zbauman3/digi-roll/README.md

# DigiRoll

A digital dice roller for D&D. Check out the docs site at https://zbauman3.github.io/digi-roll/

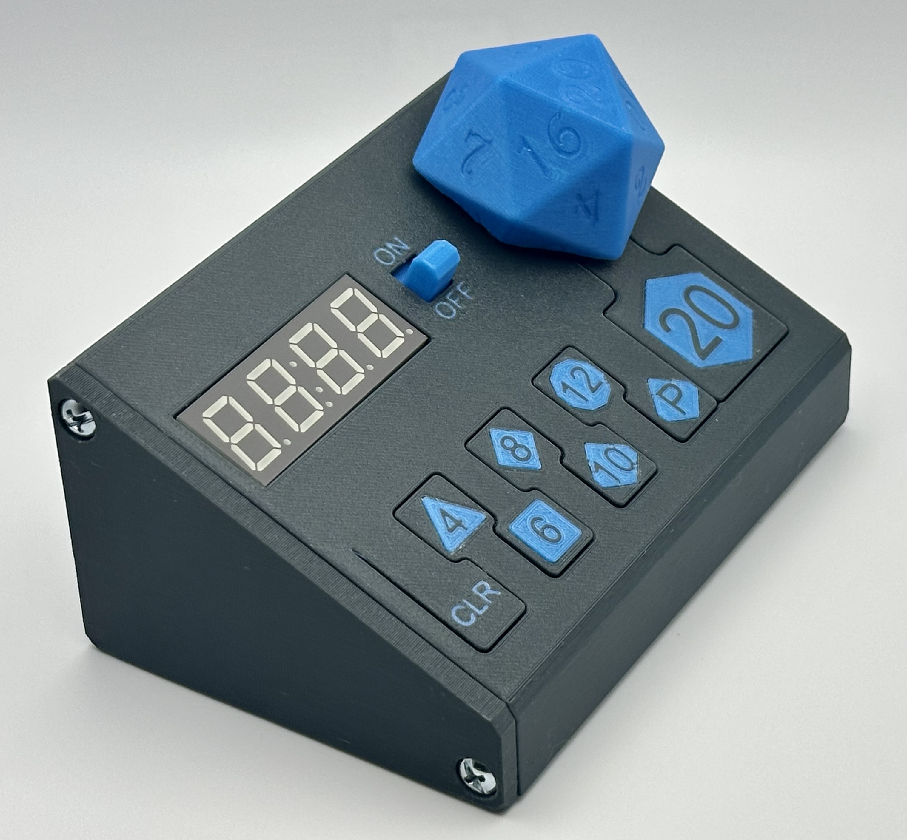
[picture p1: docs/assets/media/assembled/front-side.jpeg]
