zbauman3/digi-roll/docs/media.md

---
layout: default
title: Media
---

- [Assembled](#assembled)
- [PCB](#pcb)
- [Prototype](#prototype)
- [Schemas](#schemas)

## Assembled

<video controls="controls" class="img-full">
  <source src="./assets/media/assembled/usage-demo-1.MOV">
</video>

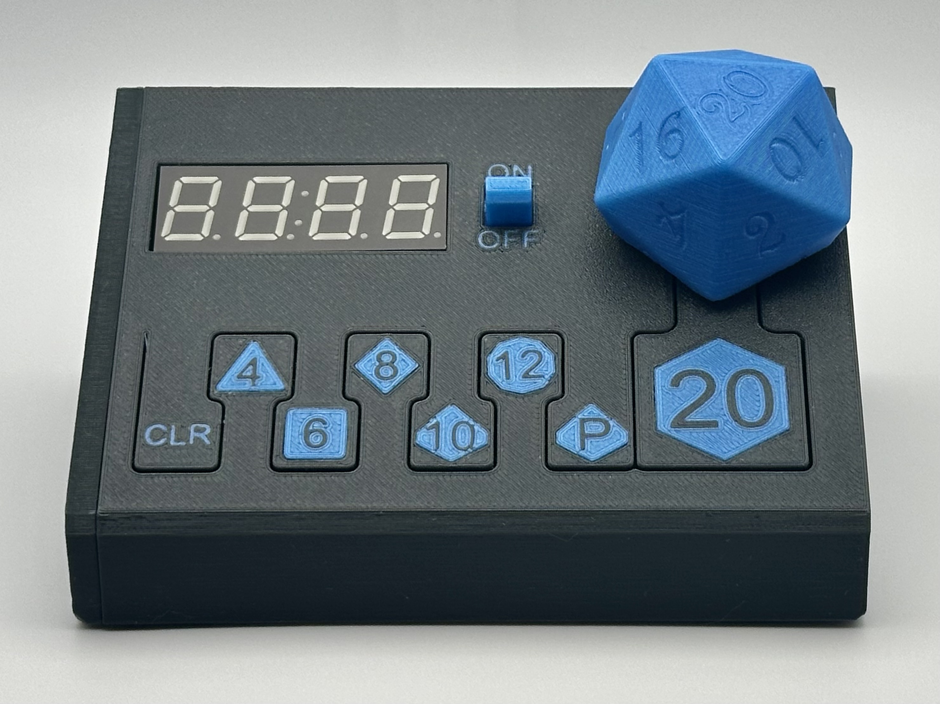
[picture p4: docs/assets/media/assembled/front.jpeg]




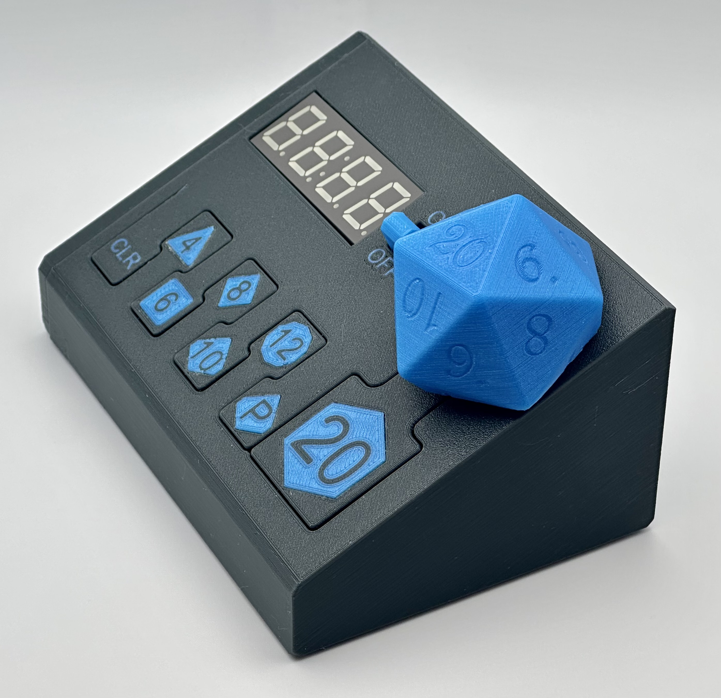
[picture p5: docs/assets/media/assembled/front-side-2.jpeg]


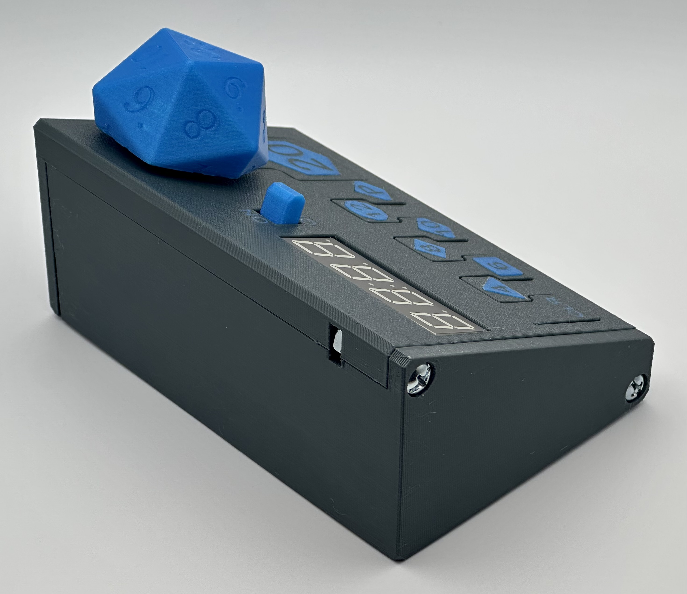
[picture p6: docs/assets/media/assembled/back-side.jpeg]


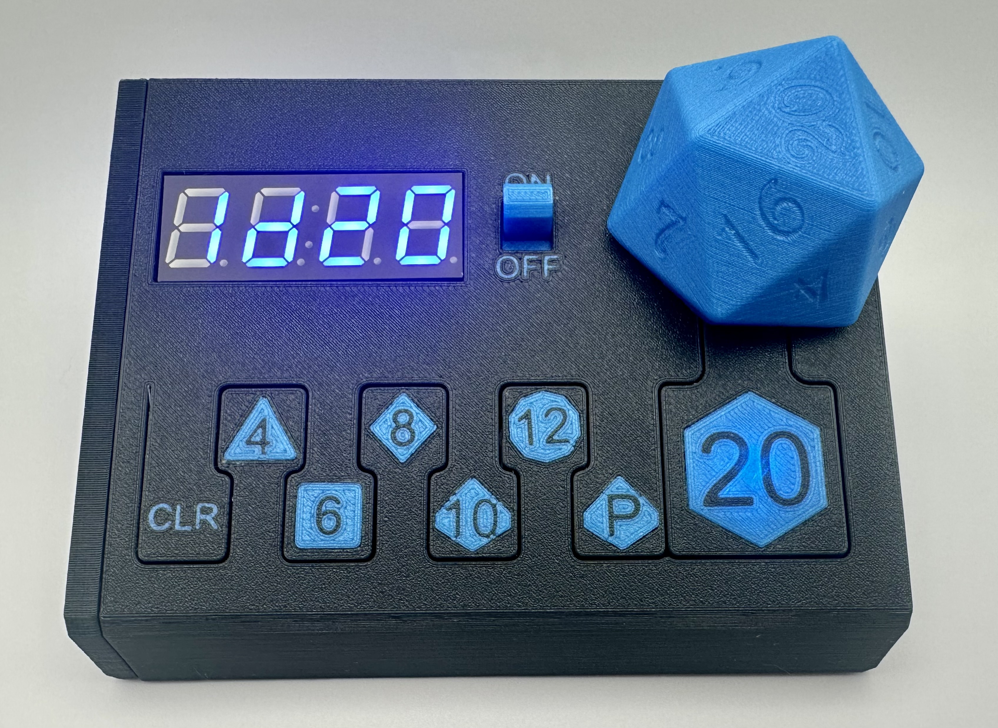
[picture p7: docs/assets/media/assembled/front-on.jpeg]


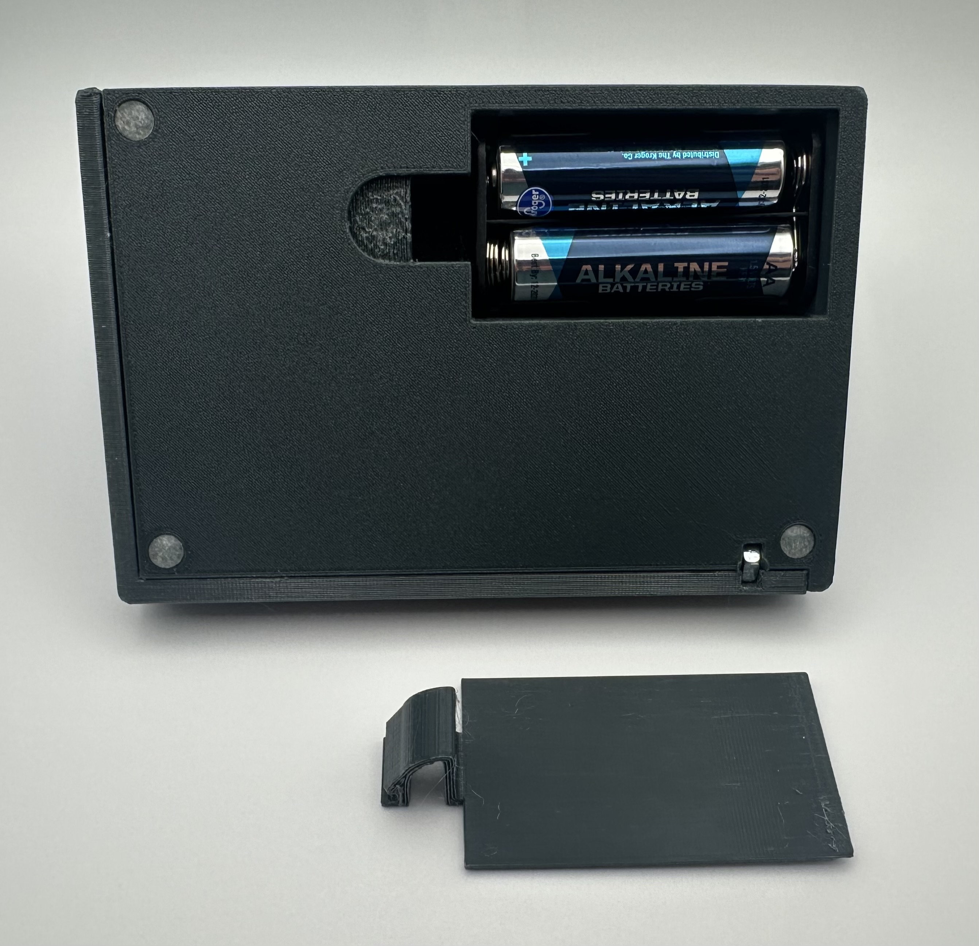
[picture p8: docs/assets/media/assembled/back.jpeg]


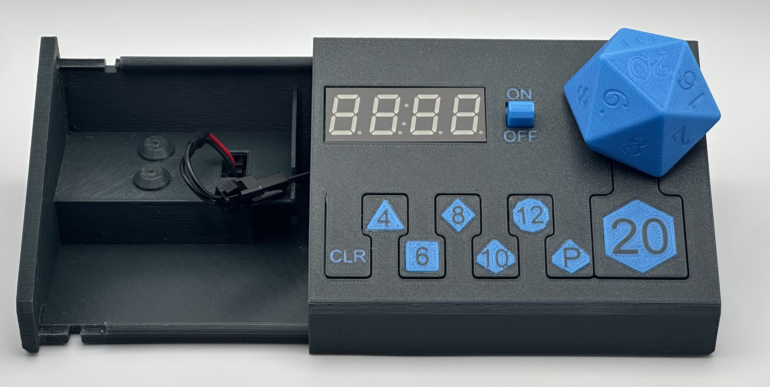
[picture p9: docs/assets/media/assembled/front-open.jpeg]


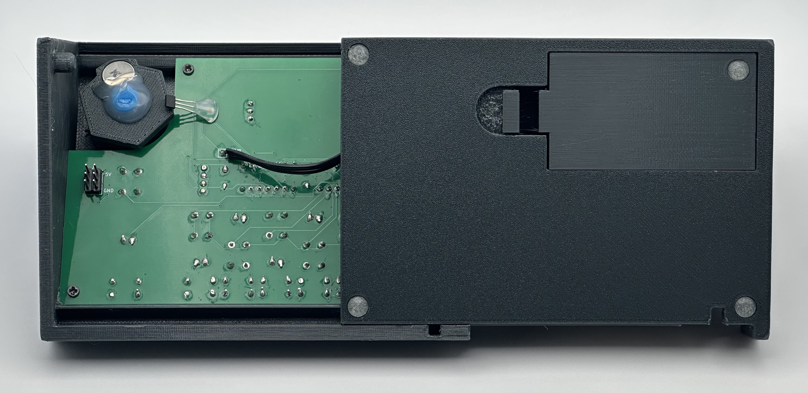
[picture p10: docs/assets/media/assembled/back-open.jpeg]


## PCB

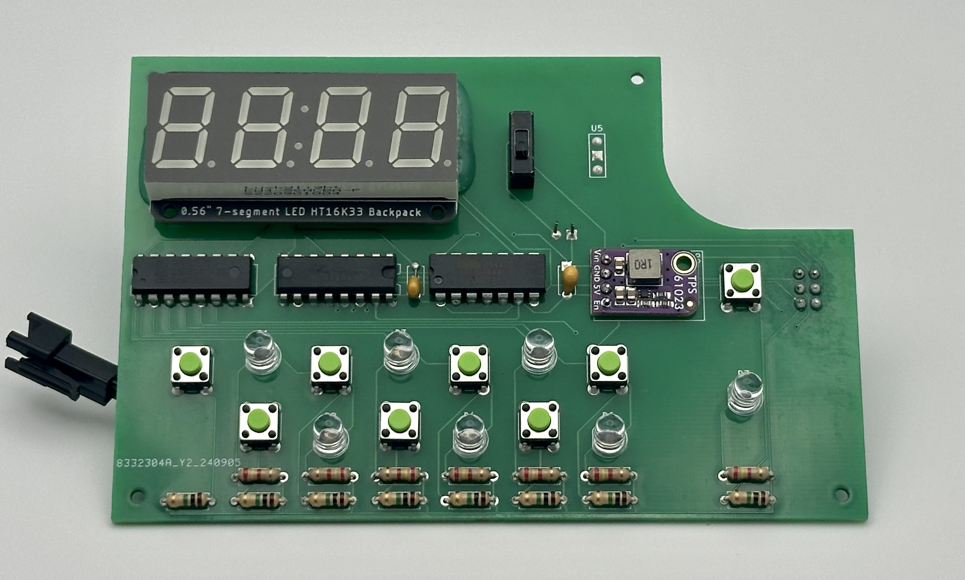
[picture p11: docs/assets/media/wip/assembled-pcb-front.jpeg]


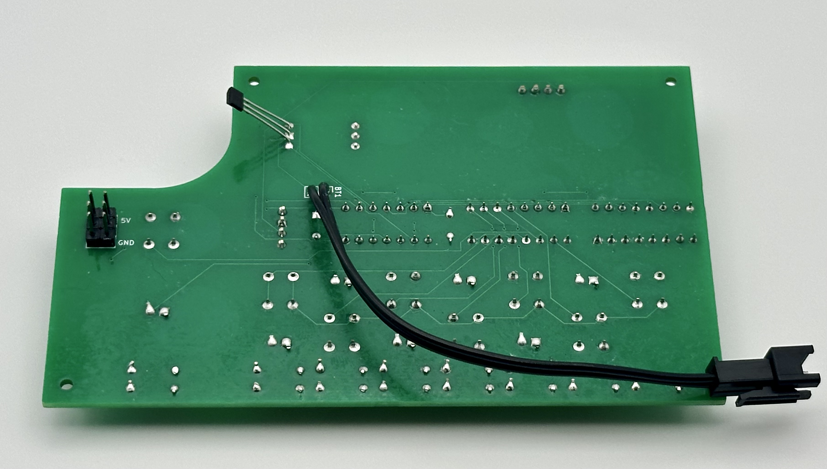
[picture p12: docs/assets/media/wip/assembled-pcb-back.jpeg]


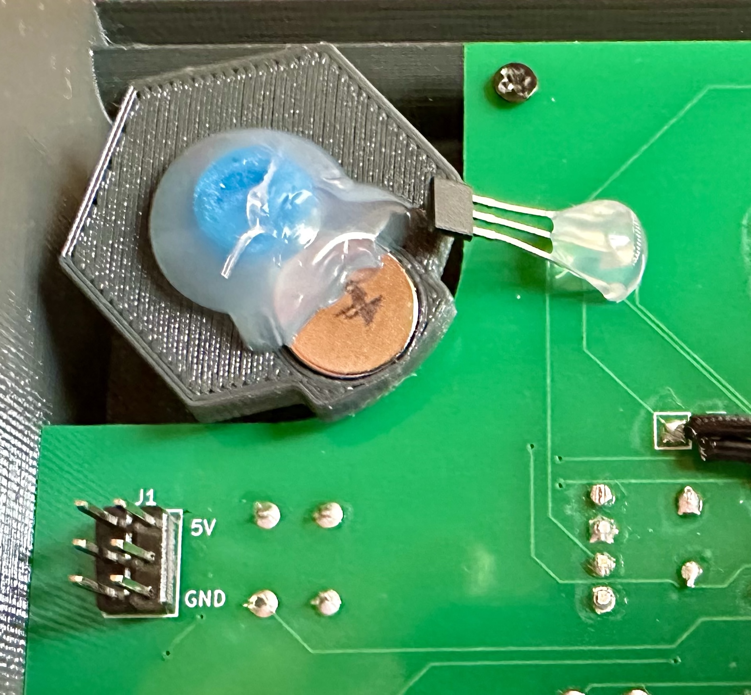
[picture p13: docs/assets/media/assembled/spinner.jpeg]


## Prototype

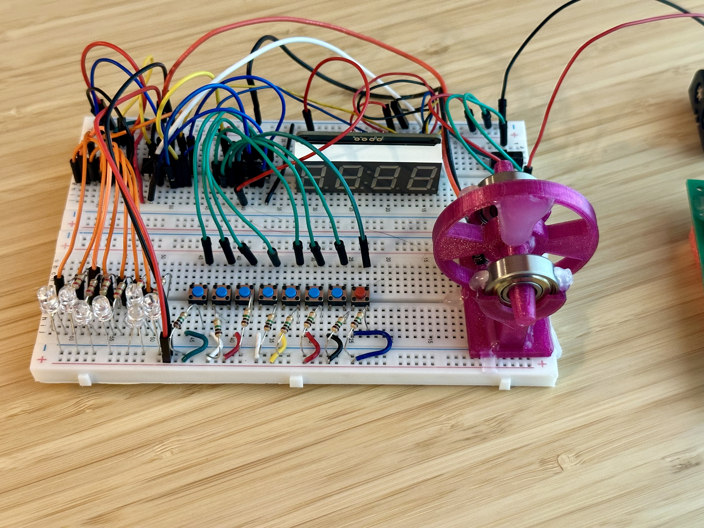
[picture p14: docs/assets/media/wip/prototype.jpeg]


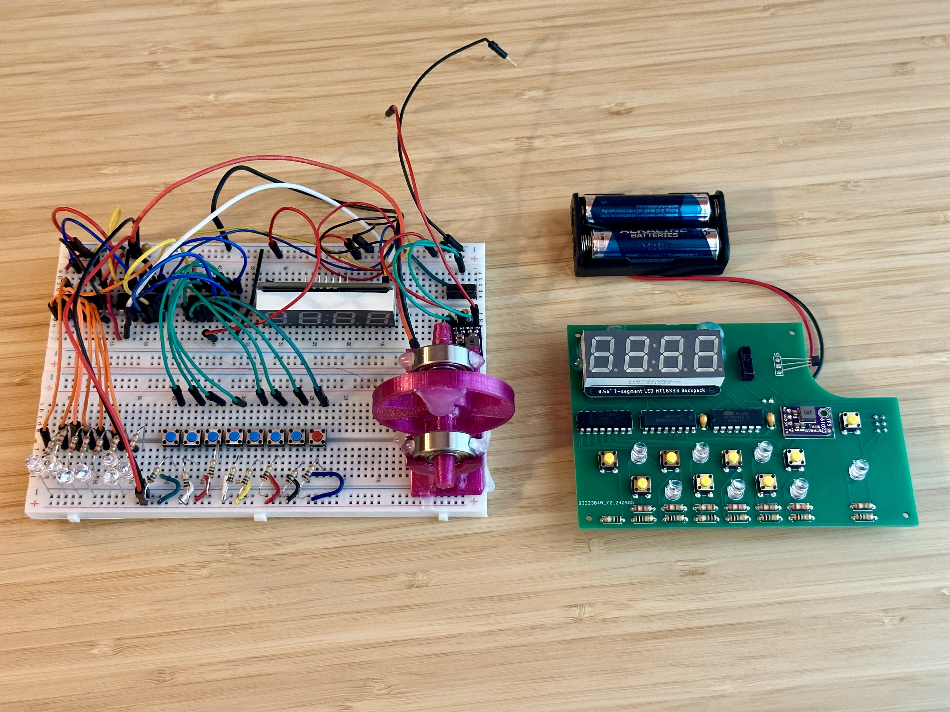
[picture p15: docs/assets/media/wip/prototype-pcb.jpeg]


## Schemas

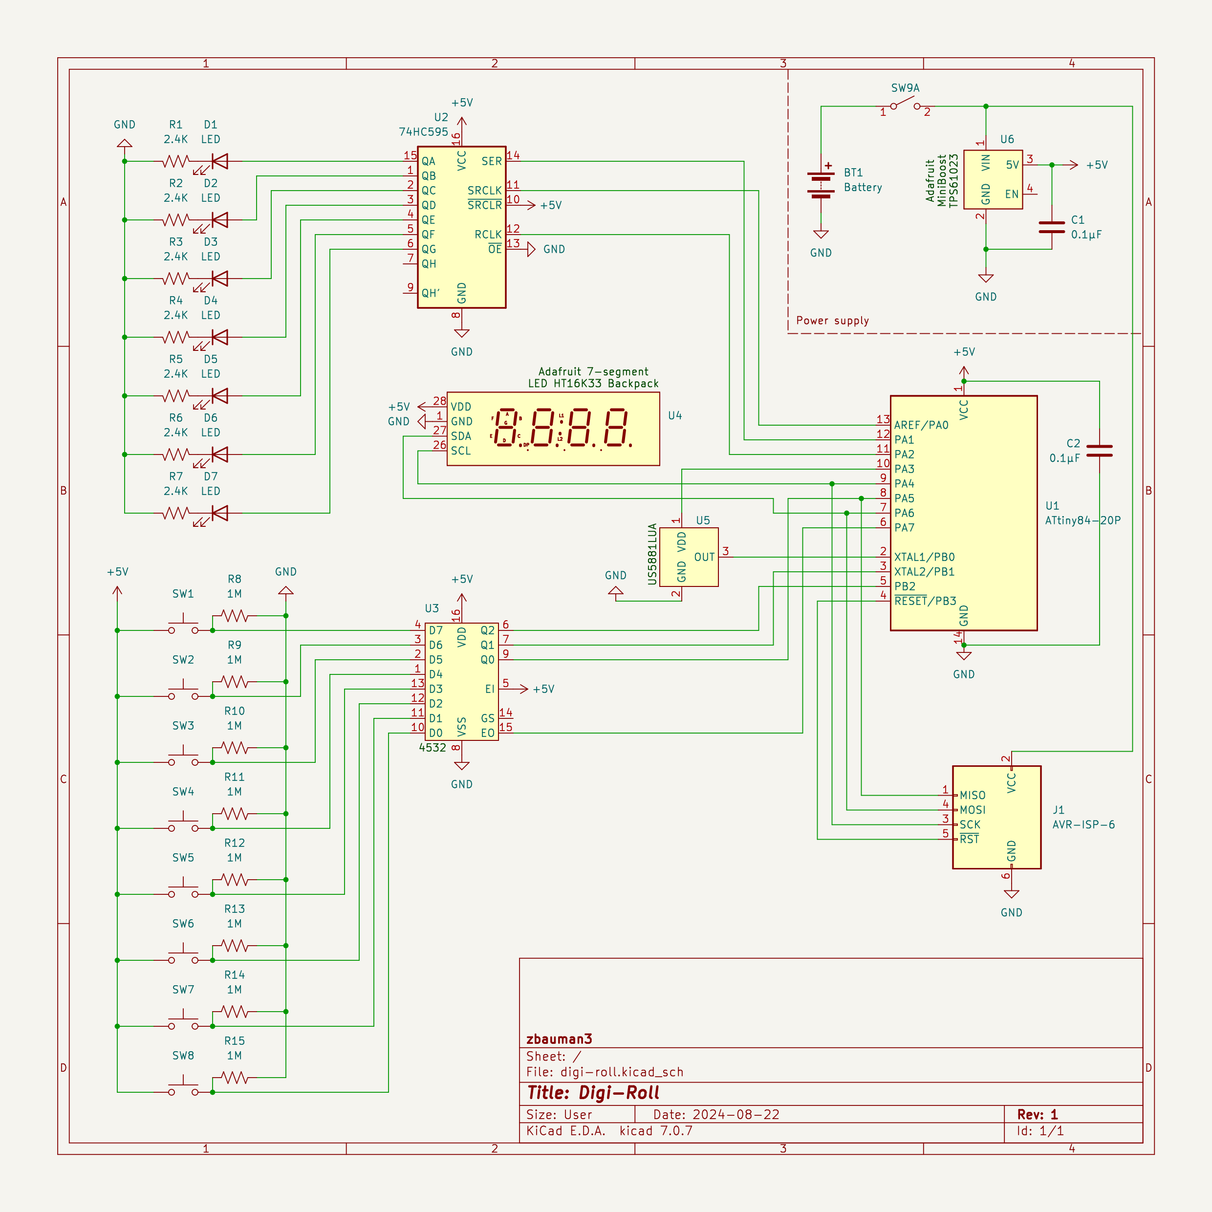
[picture p16: docs/assets/KiCad/schema.png]


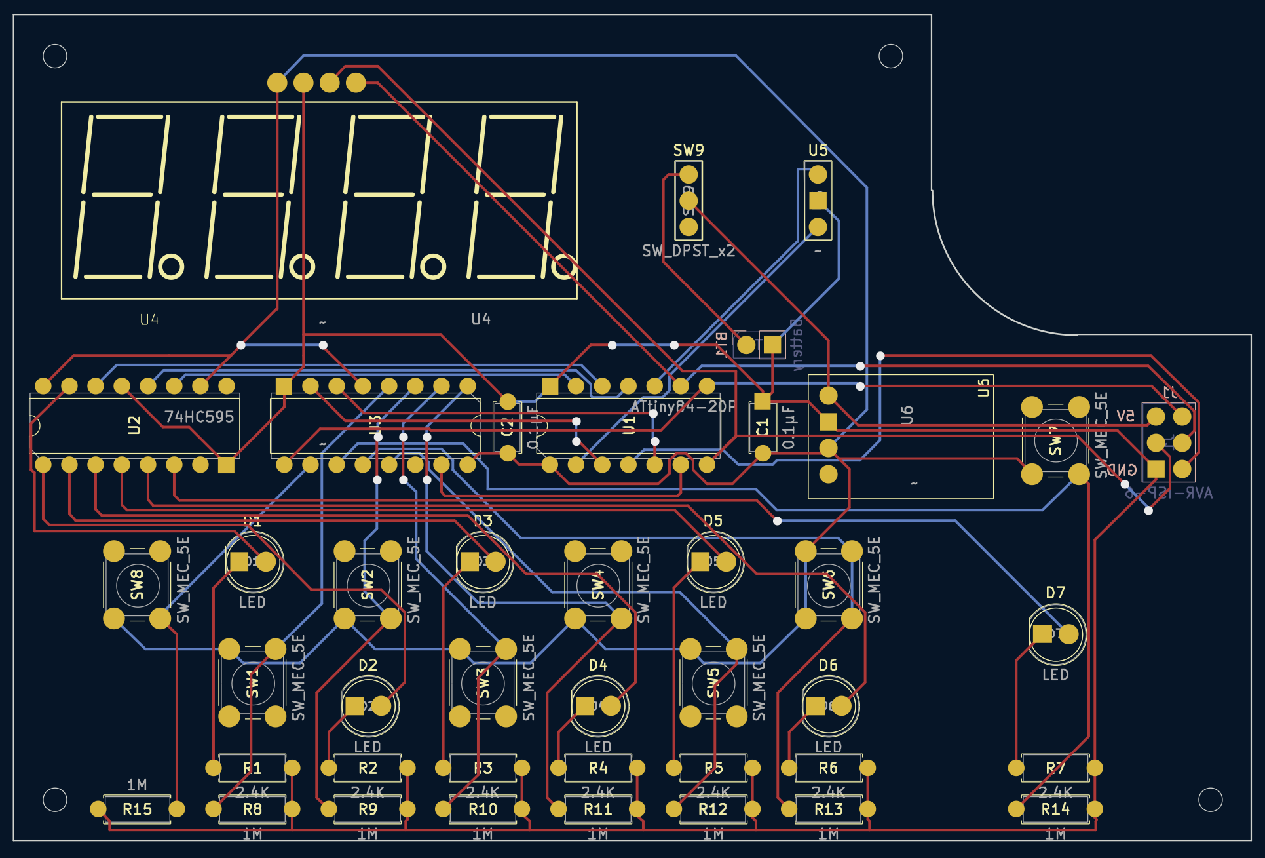
[picture p17: docs/assets/KiCad/pcb.png]
