zbauman3/digi-roll/docs/assets/media/power/active-peaks.png

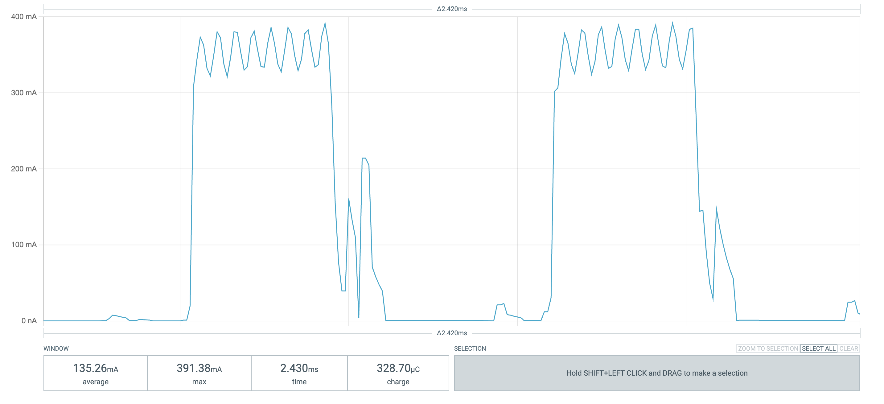
docs/assets/media/power/active-peaks.png
