zbauman3/digi-roll/docs/assets/media/power/pre-sleep-large.png

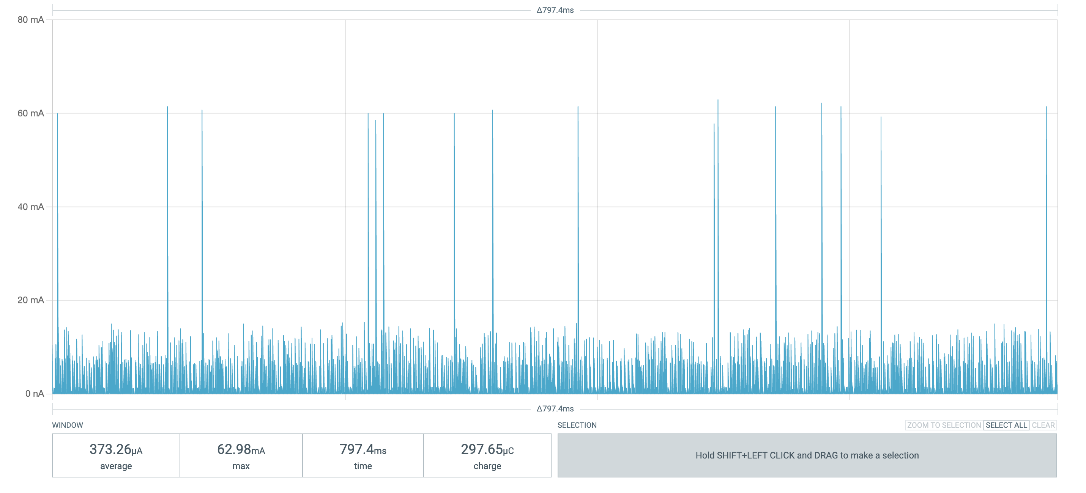
docs/assets/media/power/pre-sleep-large.png
