zbauman3/digi-roll/docs/assets/media/power/pre-sleep-peaks.png

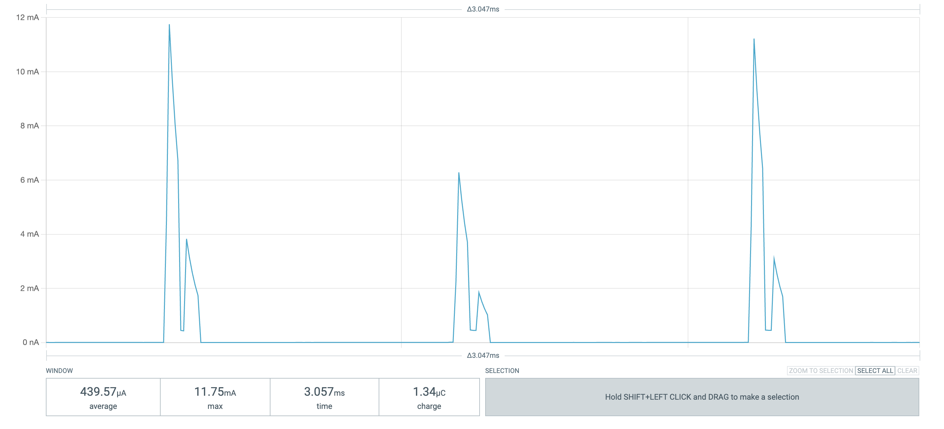
docs/assets/media/power/pre-sleep-peaks.png
