zbauman3/digi-roll/docs/assets/media/power/sleep-lows.png

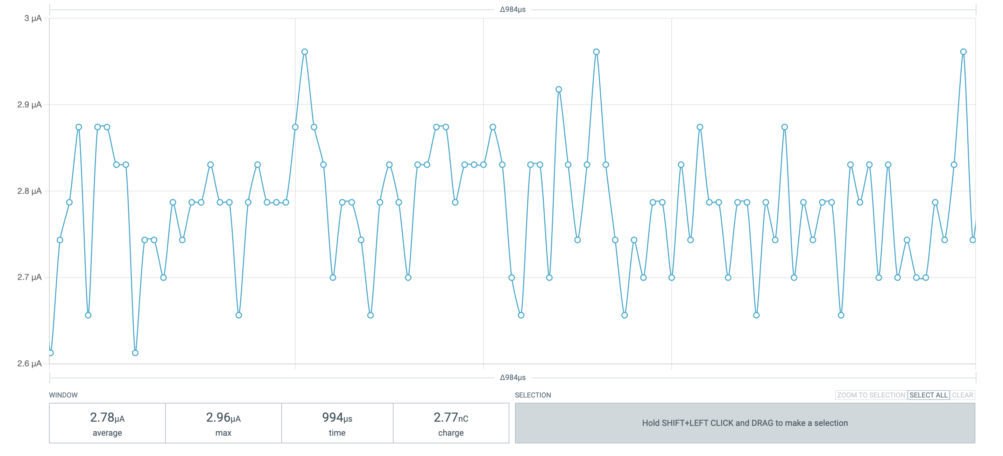
docs/assets/media/power/sleep-lows.png
