zbauman3/digi-roll/docs/assets/media/power/sleep-peaks.png

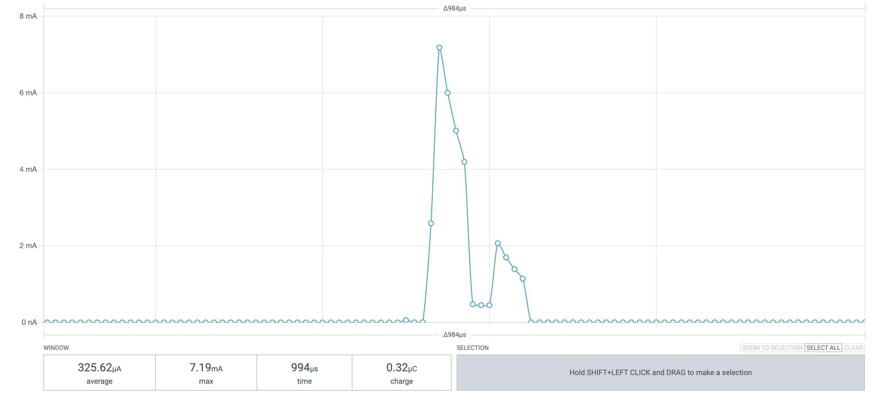
docs/assets/media/power/sleep-peaks.png
