zbauman3/digi-roll/docs/parts.md

---
layout: default
title: Parts
---

- [3D Printed Case](#3d-printed-case)
- [Electronics](#electronics)
- [Misc](#misc)

## 3D Printed Case

| Filament | Parts | Link |
| --- | --- | --- |
| Prusament PETG Anthracite Grey | External case | [Prusa](https://www.prusa3d.com/product/prusament-petg-anthracite-grey-1kg/) |
| Prusament PLA Azure Blue | Buttons, power switch, and dice spinner | [Prusa](https://www.prusa3d.com/product/prusament-pla-azure-blue-1kg/) |

## Electronics

| Part | Description | Count | Link |
| --- | --- | ----- | --- |
| ATTINY84A | Main MCU | 1 | [Mouser](https://www.mouser.com/ProductDetail/556-ATTINY84A-PU) |
| CD4532BE | 8-bit priority encoder (Buttons) | 1 | [Mouser](https://www.mouser.com/ProductDetail/595-CD4532BE) |
| SN74HC595N | Shift register (LEDs) | 1 | [Mouser](https://www.mouser.com/ProductDetail/595-SN74HC595N) |
| 7-Segment Display Breakout | I2C, 4 digit display | 1 | [Adafruit](https://www.adafruit.com/product/881) |
| TPS61023 Breakout | Boost converter | 1 | [Adafruit](https://www.adafruit.com/product/4654) |
| WP7113LVBC/D (LED) | Low current LEDs | 7 | [Mouser](https://www.mouser.com/ProductDetail/604-WP7113LVBCD) |
| 2.4K Ohm Resistors | LED resistors | 7 | [Mouser](https://www.mouser.com/ProductDetail/603-CFR-25JR-52-2K4) |
| Tactile Switches | 6 x 6 x 5mm buttons | 8 | [Adafruit](https://www.adafruit.com/product/4184) |
| 1M Ohm Resistors | Button resistors | 8 | [Mouser](https://www.mouser.com/ProductDetail/603-CFR-25JR-521M) |
| 0.1uF 50V Capacitors | Power stabilization | 2 | [Mouser](https://www.mouser.com/ProductDetail/594-K104K15X7RF5TL2) |
| SPDT Slide Switch | Power switch | 1 | [Adafruit](https://www.adafruit.com/product/805) |
| US5881UA | Hall effect sensor | 1 | [Mouser](https://www.mouser.com/ProductDetail/482-5881LUAAAA000BU) |
| Battery Holder | 2 x 1.5V AA | 1 | [Amazon](https://www.amazon.com/dp/B013GNC08C) |

## Misc

| Part | Description | Count | Link |
| --- | --- | ----- | --- |
| Rubber Feet | For the bottom of the case | 4 | [Amazon](https://www.amazon.com/dp/B07R17T68B) |
| Bearings | For the dice spinner | 2 | [Amazon](https://www.amazon.com/dp/B000OYU0TS) |
| Magnets | For the dice spinner | 1 | [Amazon](https://www.amazon.com/gp/product/B09WZTSQ9Y) |
| Battery Connectors | Allows disconnecting the battery from the board for easy installation | 1 | [Adafruit](https://www.adafruit.com/product/2880) |
| PCB Screws | M2 x 8mm | 4 | N/A |
| Hot glue | Securing the display and the magnet holer | - | N/A |
| Tacking screws | Attaching the battery holder to the case | 2 | N/A |
| Header pins | Attaching the breakout boards and a ISP connection for programming | 14 | N/A |
