zbauman3/digi-roll/docs/assets/KiCad/digi-roll.kicad_pcb

## KiCad design docs/assets/KiCad/digi-roll.kicad_pcb (2024-09-13)

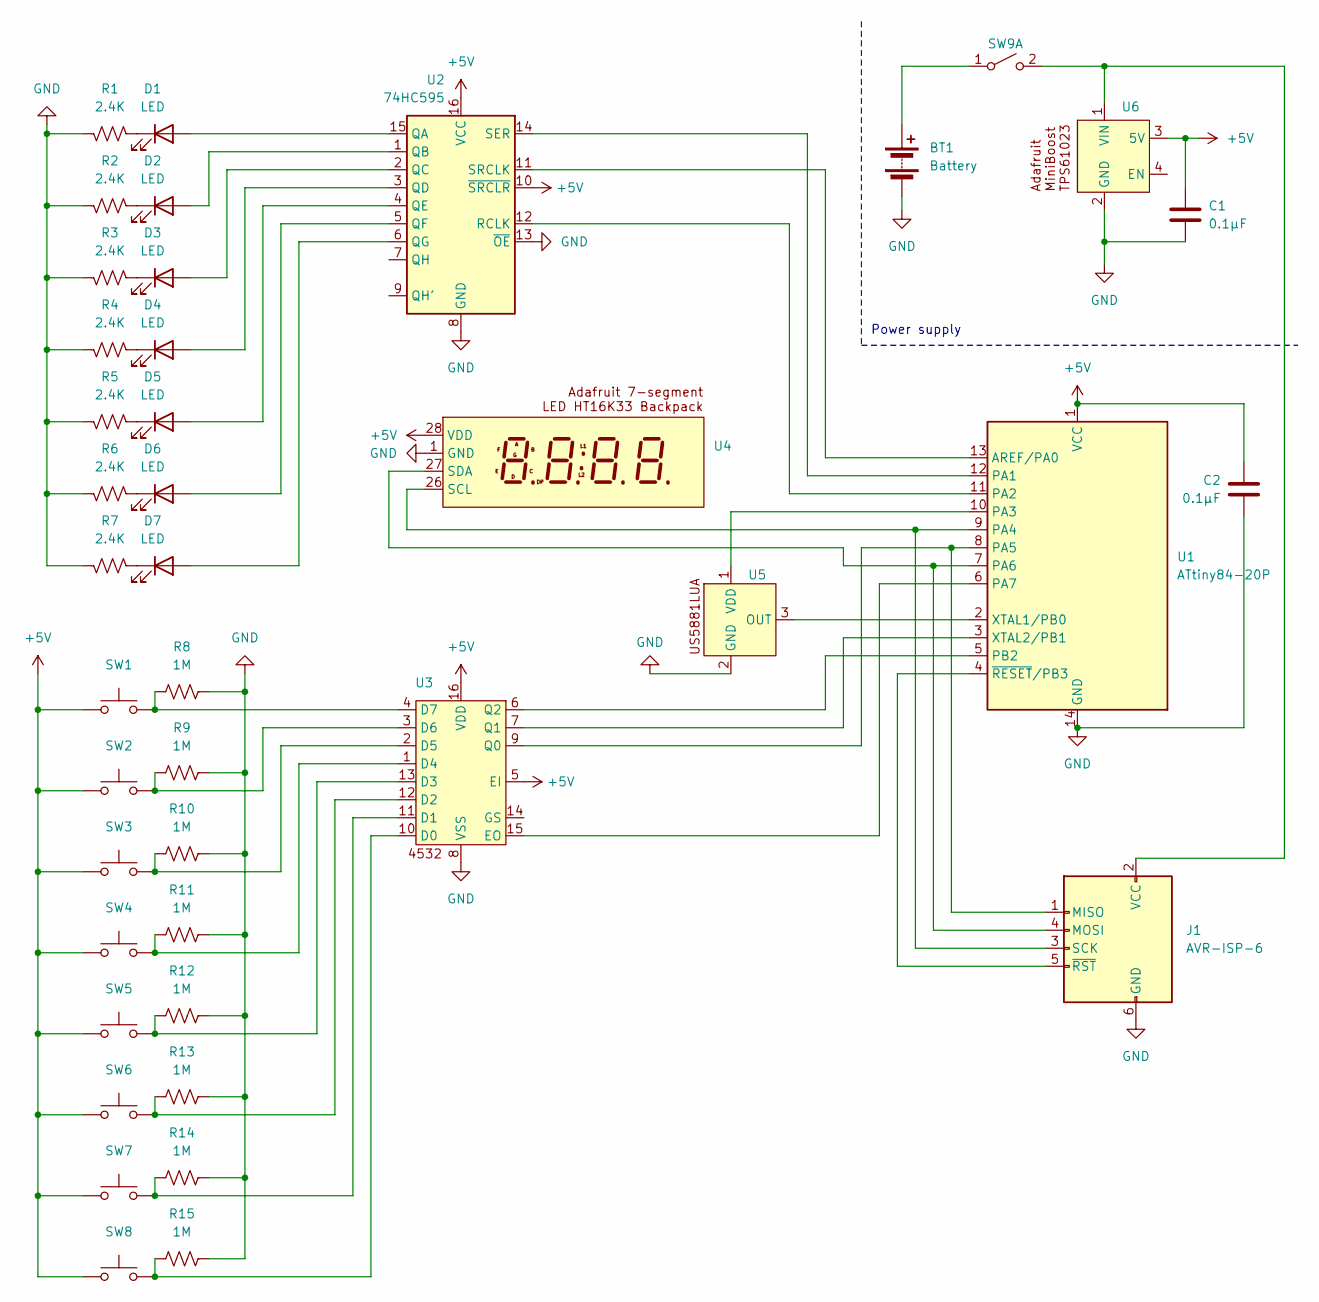
[picture p23: schematic digi-roll.kicad_sch]

Parts:
BT1: Battery; PinHeader_1x02_P2.54mm_Vertical
C1, C2: 0.1µF; C_Disc_D4.7mm_W2.5mm_P5.00mm
D1, D2, D3, D4, D5, D6, D7: LED; LED_D5.0mm
J1: AVR-ISP-6; PinHeader_2x03_P2.54mm_Vertical
R1, R2, R3, R4, R5, R6, R7: 2.4K; R_Axial_DIN0207_L6.3mm_D2.5mm_P7.62mm_Horizontal
R8, R9, R10, R11, R12, R13, R14, R15: 1M; R_Axial_DIN0207_L6.3mm_D2.5mm_P7.62mm_Horizontal
SW1, SW2, SW3, SW4, SW5, SW6, SW7, SW8: SW_MEC_5E; SW_PUSH_6mm_H5mm
SW9: SW_DPST_x2; PinHeader_1x02_P2.54mm_Vertical
U1: ATtiny84-20P; DIP-14_W7.62mm
U2: 74HC595; DIP-16_W7.62mm
U3: DIP-16_W7.62mm
U4: Adafruit_7_seg
U5: PinHeader_1x03_P2.54mm_Vertical
U6: Adafruit_Miniboost

Connections:
+5V: C1.1, C2.1, SW1.1, SW2.1, SW3.1, SW4.1, SW5.1, SW6.1, SW7.1, SW8.1, U1.1 (VCC), U2.10 (~SRCLR), U2.16 (VCC), U3.5 (EI), U3.16 (VDD), U4.28 (VDD), U6.3 (5V)
GND: BT1.2 (-), C1.2, C2.2, J1.6 (GND), R1.2, R2.2, R3.2, R4.2, R5.2, R6.2, R7.2, R8.2, R9.2, R10.2, R11.2, R12.2, R13.2, R14.2, R15.2, U1.14 (GND), U2.8 (GND), U2.13 (~OE), U3.8 (VSS), U4.1 (GND), U5.2 (GND), U6.2 (GND)
unnamed: BT1.1 (+), SW9.1 (A)
unnamed: D1.2 (A), U2.15 (QA)
unnamed: D1.1 (K), R1.1
unnamed: D2.2 (A), U2.1 (QB)
unnamed: D2.1 (K), R2.1
unnamed: D3.2 (A), U2.2 (QC)
unnamed: D3.1 (K), R3.1
unnamed: D4.2 (A), U2.3 (QD)
unnamed: D4.1 (K), R4.1
unnamed: D5.2 (A), U2.4 (QE)
unnamed: D5.1 (K), R5.1
unnamed: D6.2 (A), U2.5 (QF)
unnamed: D6.1 (K), R6.1
unnamed: D7.2 (A), U2.6 (QG)
unnamed: D7.1 (K), R7.1
unnamed: J1.1 (MISO), U1.8 (PA5), U3.9 (Q0)
unnamed: J1.4 (MOSI), U1.7 (PA6), U4.27 (SDA)
unnamed: J1.3 (SCK), U1.9 (PA4), U4.26 (SCL)
unnamed: J1.2 (VCC), SW9.2 (B), U6.1 (VIN)
unnamed: J1.5 (~RST), U1.4 (~RESET/PB3)
unnamed: U1.13 (AREF/PA0), U2.11 (SRCLK)
unnamed: U1.12 (PA1), U2.14 (SER)
unnamed: U1.11 (PA2), U2.12 (RCLK)
unnamed: U1.10 (PA3), U5.1 (VDD)
unnamed: U1.6 (PA7), U3.15 (EO)
unnamed: U1.5 (PB2), U3.6 (Q2)
unnamed: U1.2 (XTAL1/PB0), U5.3 (OUT)
unnamed: U1.3 (XTAL2/PB1), U3.7 (Q1)
unnamed: R15.1, SW8.2, U3.10 (D0)
unnamed: R14.1, SW7.2, U3.11 (D1)
unnamed: R13.1, SW6.2, U3.12 (D2)
unnamed: R12.1, SW5.2, U3.13 (D3)
unnamed: R11.1, SW4.2, U3.1 (D4)
unnamed: R10.1, SW3.2, U3.2 (D5)
unnamed: R9.1, SW2.2, U3.3 (D6)
unnamed: R8.1, SW1.2, U3.4 (D7)

Notes on the sheet:
Power supply

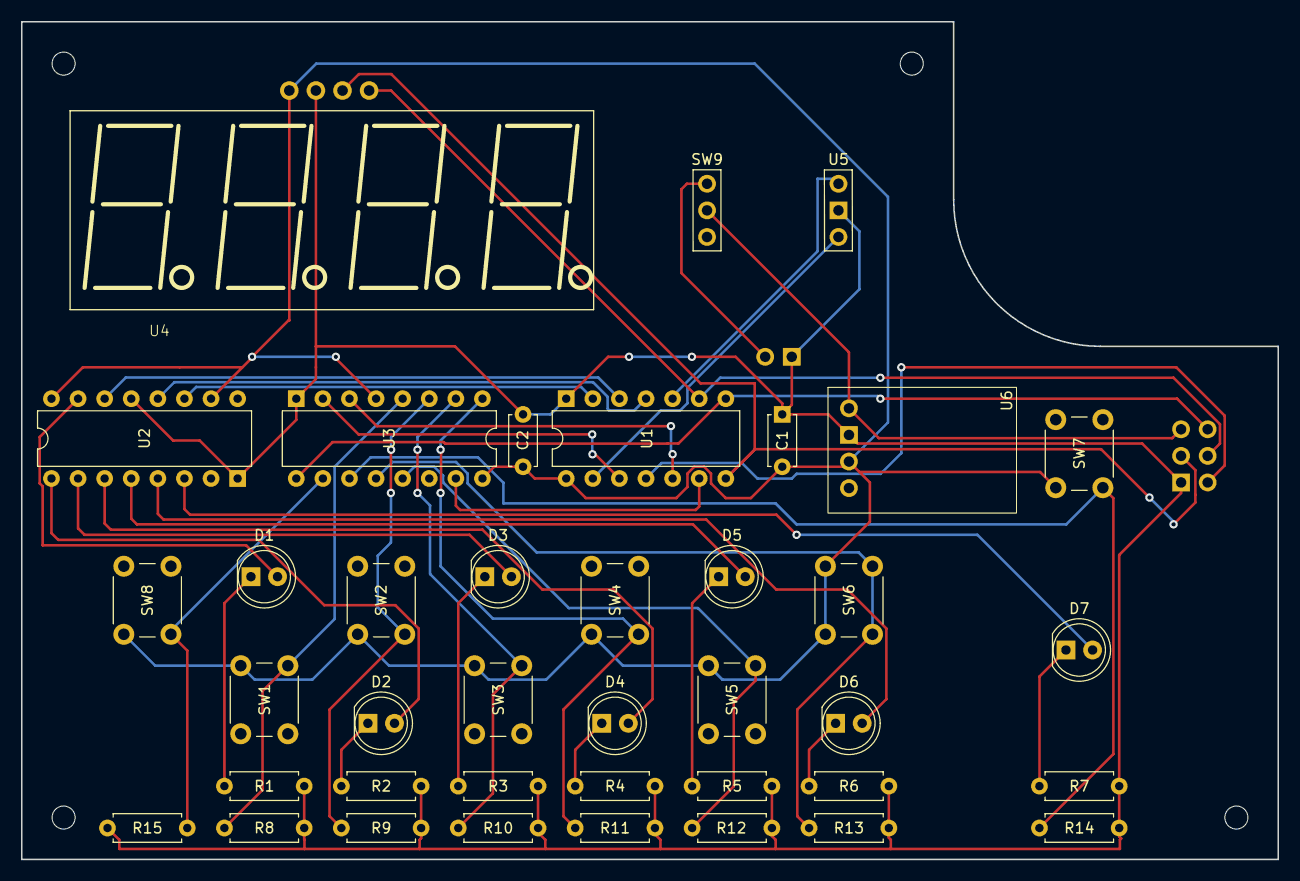
[picture p24: board digi-roll.kicad_pcb from above]

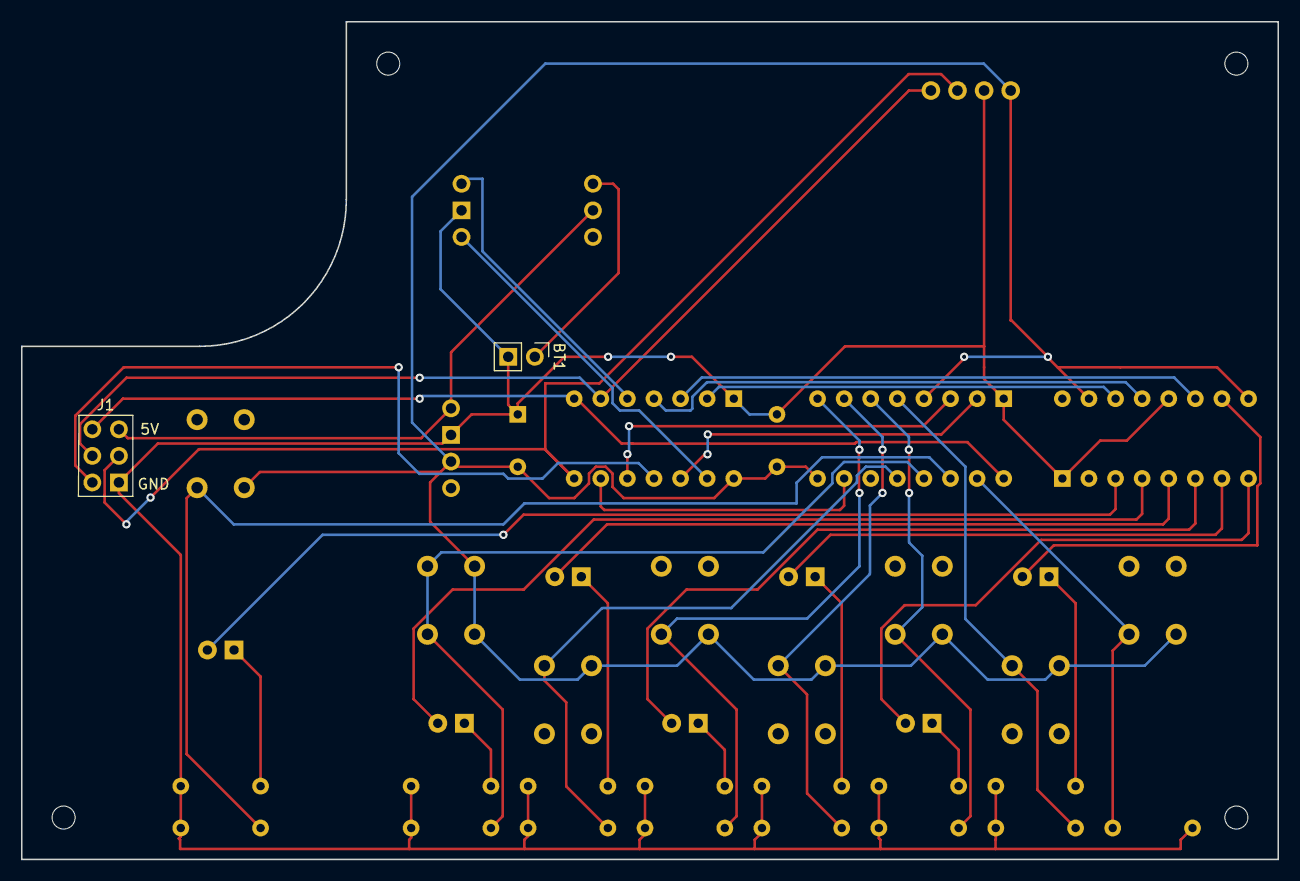
[picture p25: board digi-roll.kicad_pcb from below]

Board: 2 copper layers, 120.0 x 80.0 mm, 41 parts (2 on the bottom side), 38 nets.
