zbauman3/digi-roll/src/views/MatrixDisplay.cpp

#include "./MatrixDisplay.h"

// !! README !!
// Don't use the string functions from `Adafruit_7segment`.
// They take too much space.

MatrixDisplay::MatrixDisplay(State *_state) {
  this->state = _state;
  this->matrix = Adafruit_7segment();
};

void MatrixDisplay::begin() {
  this->matrix.begin(MATRIX_DISPLAY_ADDR);
  this->matrix.setBrightness(this->state->data.brightness);
  this->_lastBrightness = this->state->data.brightness;
}

void MatrixDisplay::loop() {
  if (this->state->isUpdateLoop) {
    // sleep/wake the HT16K33, otherwise is can use multiple mA.
    // `Adafruit_7segment` doesn't give access to its internal `Wire`, but it
    // defaults to the global one. So we can just use that too.
    // @see https://cdn-shop.adafruit.com/datasheets/ht16K33v110.pdf
    if (this->state->data.mode == STATE_MODE_SLEEP) {
      // clear anything
      this->matrix.clear();
      this->matrix.writeDisplay();
      // sleep the display
      uint8_t buffer[1] = {0x20};
      Wire.beginTransmission(MATRIX_DISPLAY_ADDR);
      while (Wire.write(buffer, 1) != 1) {
        delay(1);
      }
      Wire.endTransmission(true);

      // if sleeping, don't run the coroutine
      return;
    } else if (this->state->data.mode == STATE_MODE_WAKE) {
      // wake the display
      uint8_t buffer[1] = {0x21};
      Wire.beginTransmission(MATRIX_DISPLAY_ADDR);
      while (Wire.write(buffer, 1) != 1) {
        delay(1);
      }
      Wire.endTransmission(true);

      // if waking, reset
      this->reset();
    }
  }

  this->runCoroutine();
}

int MatrixDisplay::runCoroutine() {
  COROUTINE_LOOP() {
    if (this->state->isUpdateLoop) {
      if (this->_lastBrightness != this->state->data.brightness) {
        this->matrix.setBrightness(this->state->data.brightness);
        this->_lastBrightness = this->state->data.brightness;
        // yield after transmit to give others a turn to run
        COROUTINE_YIELD();
      }

      this->matrix.clear();

      if (this->state->data.mode == STATE_MODE_SELECT_DICE) {
        // show results in `2d20` format
        this->matrix.writeDigitNum(0, this->state->data.diceCount);
        this->matrix.writeDigitAscii(1, 'd');

        uint8_t diceCount = this->state->getDiceCount();
        switch (diceCount) {
        case 4:
        case 6:
        case 8:
          this->matrix.writeDigitNum(4, diceCount);
          break;
        case 10:
        case 12:
          this->matrix.writeDigitNum(3, 1);
          this->matrix.writeDigitNum(4, diceCount % 10);
          break;
        case 100:
          // It's a "percentile" roll, so we can show "P". "100" won't fit
          this->matrix.writeDigitAscii(4, 'P');
          break;
        case 20:
        default:
          this->matrix.writeDigitNum(3, 2);
          this->matrix.writeDigitNum(4, 0);
          break;
        }

        this->matrix.writeDisplay();
      } else if (this->state->data.mode == STATE_MODE_ROLLING) {
        // animate a circle around each segment in a row
        for (this->j = 0; this->j < 5; this->j++) {
          if (this->j == 2) {
            this->j++;
          }

          for (this->i = 0; this->i < 6; this->i++) {
            this->matrix.writeDigitRaw(this->j, (1 << this->i));
            this->matrix.writeDisplay();
            COROUTINE_DELAY(30);
          }

          this->matrix.writeDigitRaw(this->j, 1);
          this->matrix.writeDisplay();
          COROUTINE_DELAY(30);

          this->matrix.writeDigitRaw(this->j, 0);
          this->matrix.writeDisplay();
        }

        this->state->setModeResults();
      } else if (this->state->data.mode == STATE_MODE_RESULTS) {
        // show the results in `2. 20` format
        // only show the selected dice if more than one was rolled
        if (this->state->data.diceCount > 1) {
          // if resultIndex == diceCount, show the sum
          if (this->state->data.resultIndex == this->state->data.diceCount) {
            this->matrix.writeDigitAscii(0, '=');
          } else {
            this->matrix.writeDigitNum(0, this->state->data.resultIndex + 1,
                                       true);
          }
        }

        uint16_t dispResult = 0;

        // if resultIndex == diceCount, show the sum
        if (this->state->data.resultIndex == this->state->data.diceCount) {
          for (this->i = 0; this->i < this->state->data.diceCount; this->i++) {
            dispResult += this->state->data.results[this->i];
          }
        } else {
          dispResult = this->state->data.results[this->state->data.resultIndex];
        }

        if (dispResult < 10) {
          this->matrix.writeDigitNum(4, dispResult);
        } else if (dispResult < 100) {
          this->matrix.writeDigitNum(3, (uint8_t)ceil(dispResult / 10));
          this->matrix.writeDigitNum(4, (uint8_t)(dispResult % 10));
        } else {
          this->matrix.writeDigitNum(1, (uint8_t)ceil(dispResult / 100));
          this->matrix.writeDigitNum(3, (uint8_t)ceil((dispResult % 100) / 10));
          this->matrix.writeDigitNum(4, (uint8_t)(dispResult % 10));
        }

        this->matrix.writeDisplay();
      }
    }

    COROUTINE_YIELD();
  }
}
