zbauman3/digi-roll/(commit log)

2024-08-12 init buttons in interrupts
2024-08-12 abstract button presses
2024-08-17 cleanup buttons - cleanup state
2024-08-21 LED blinking
2024-08-21 bpj to enable/disable HALL for low power
2024-08-22 finish low power mode
2024-08-22 add results sleep, reset _lastRolledAt, new display
    [MatrixDisplay.cpp]
2024-08-24 better button debouncing
2024-08-24 remove BPJ for HALL
    [digi-roll.kicad_sch]
2024-09-05 finish PCB order
    [digi-roll.kicad_pcb, digi-roll.kicad_sch]
2024-09-11 Update to match the hardware button order
2024-11-24 tune and 3d models
    [digi-roll-case v76.stl]
2024-11-26 init docs
    [digi-roll-case v76.stl, digi-roll.kicad_pcb, digi-roll.kicad_sch]
